b1ackmai1er/ECB-4PIO-I2C/ECB-4PIO-I2CC/ECB-4PIO.kicad_pcb

## KiCad design ECB-4PIO-I2CC/ECB-4PIO.kicad_pcb (2021-04-21)

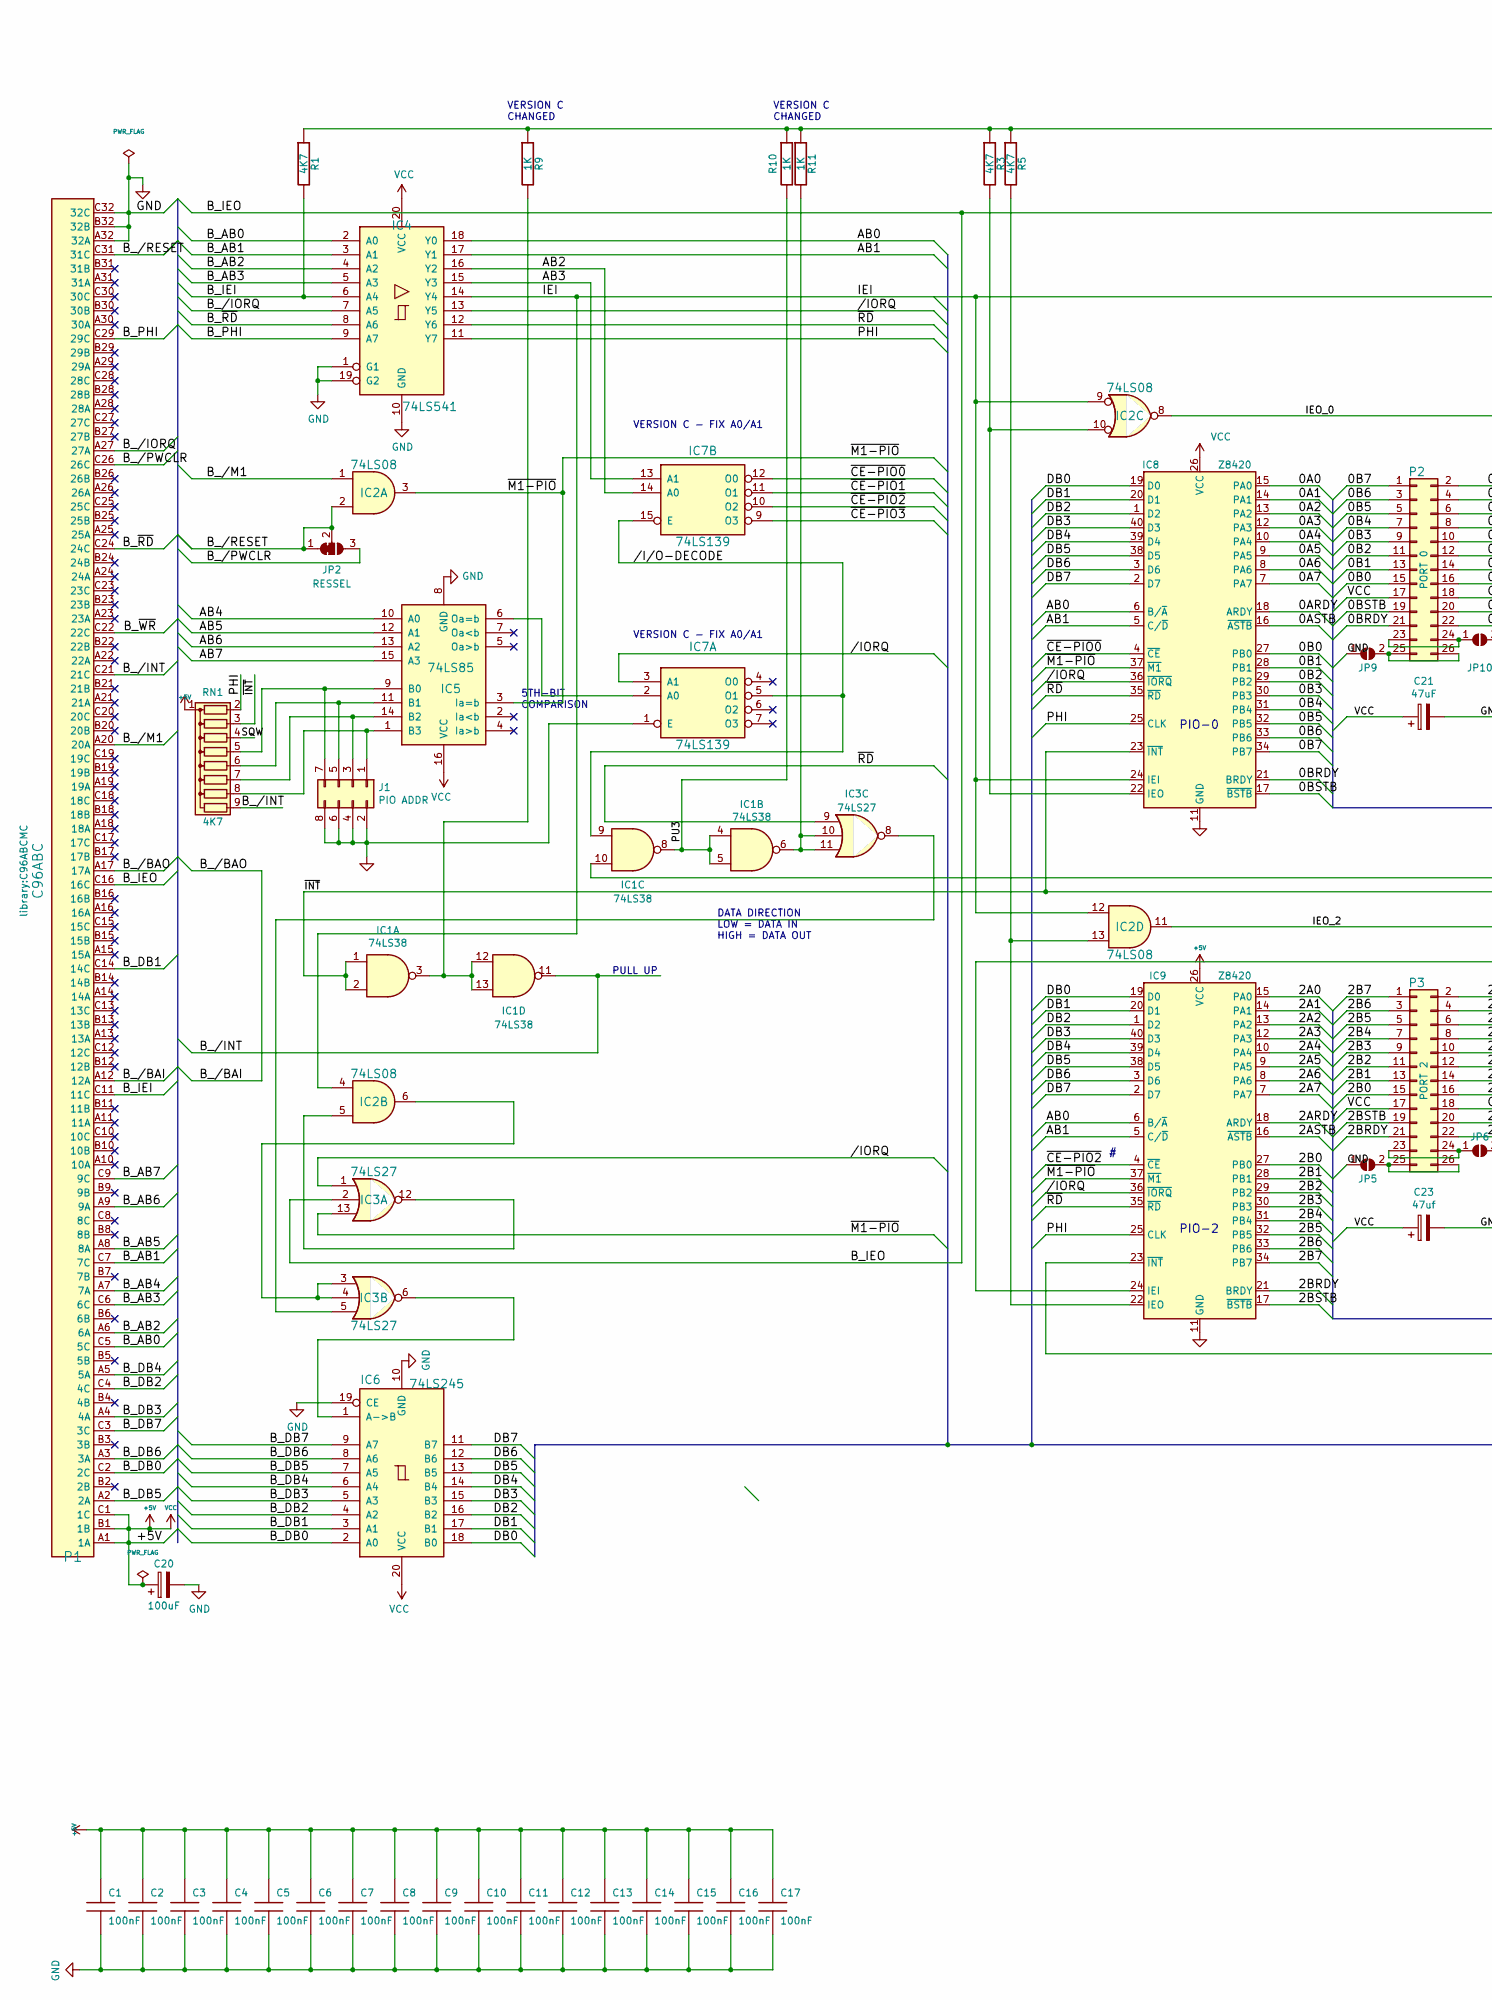
[picture p1: schematic ECB-4PIO.sch, ECB-4PIO-I2C, part in row 1, column 1]

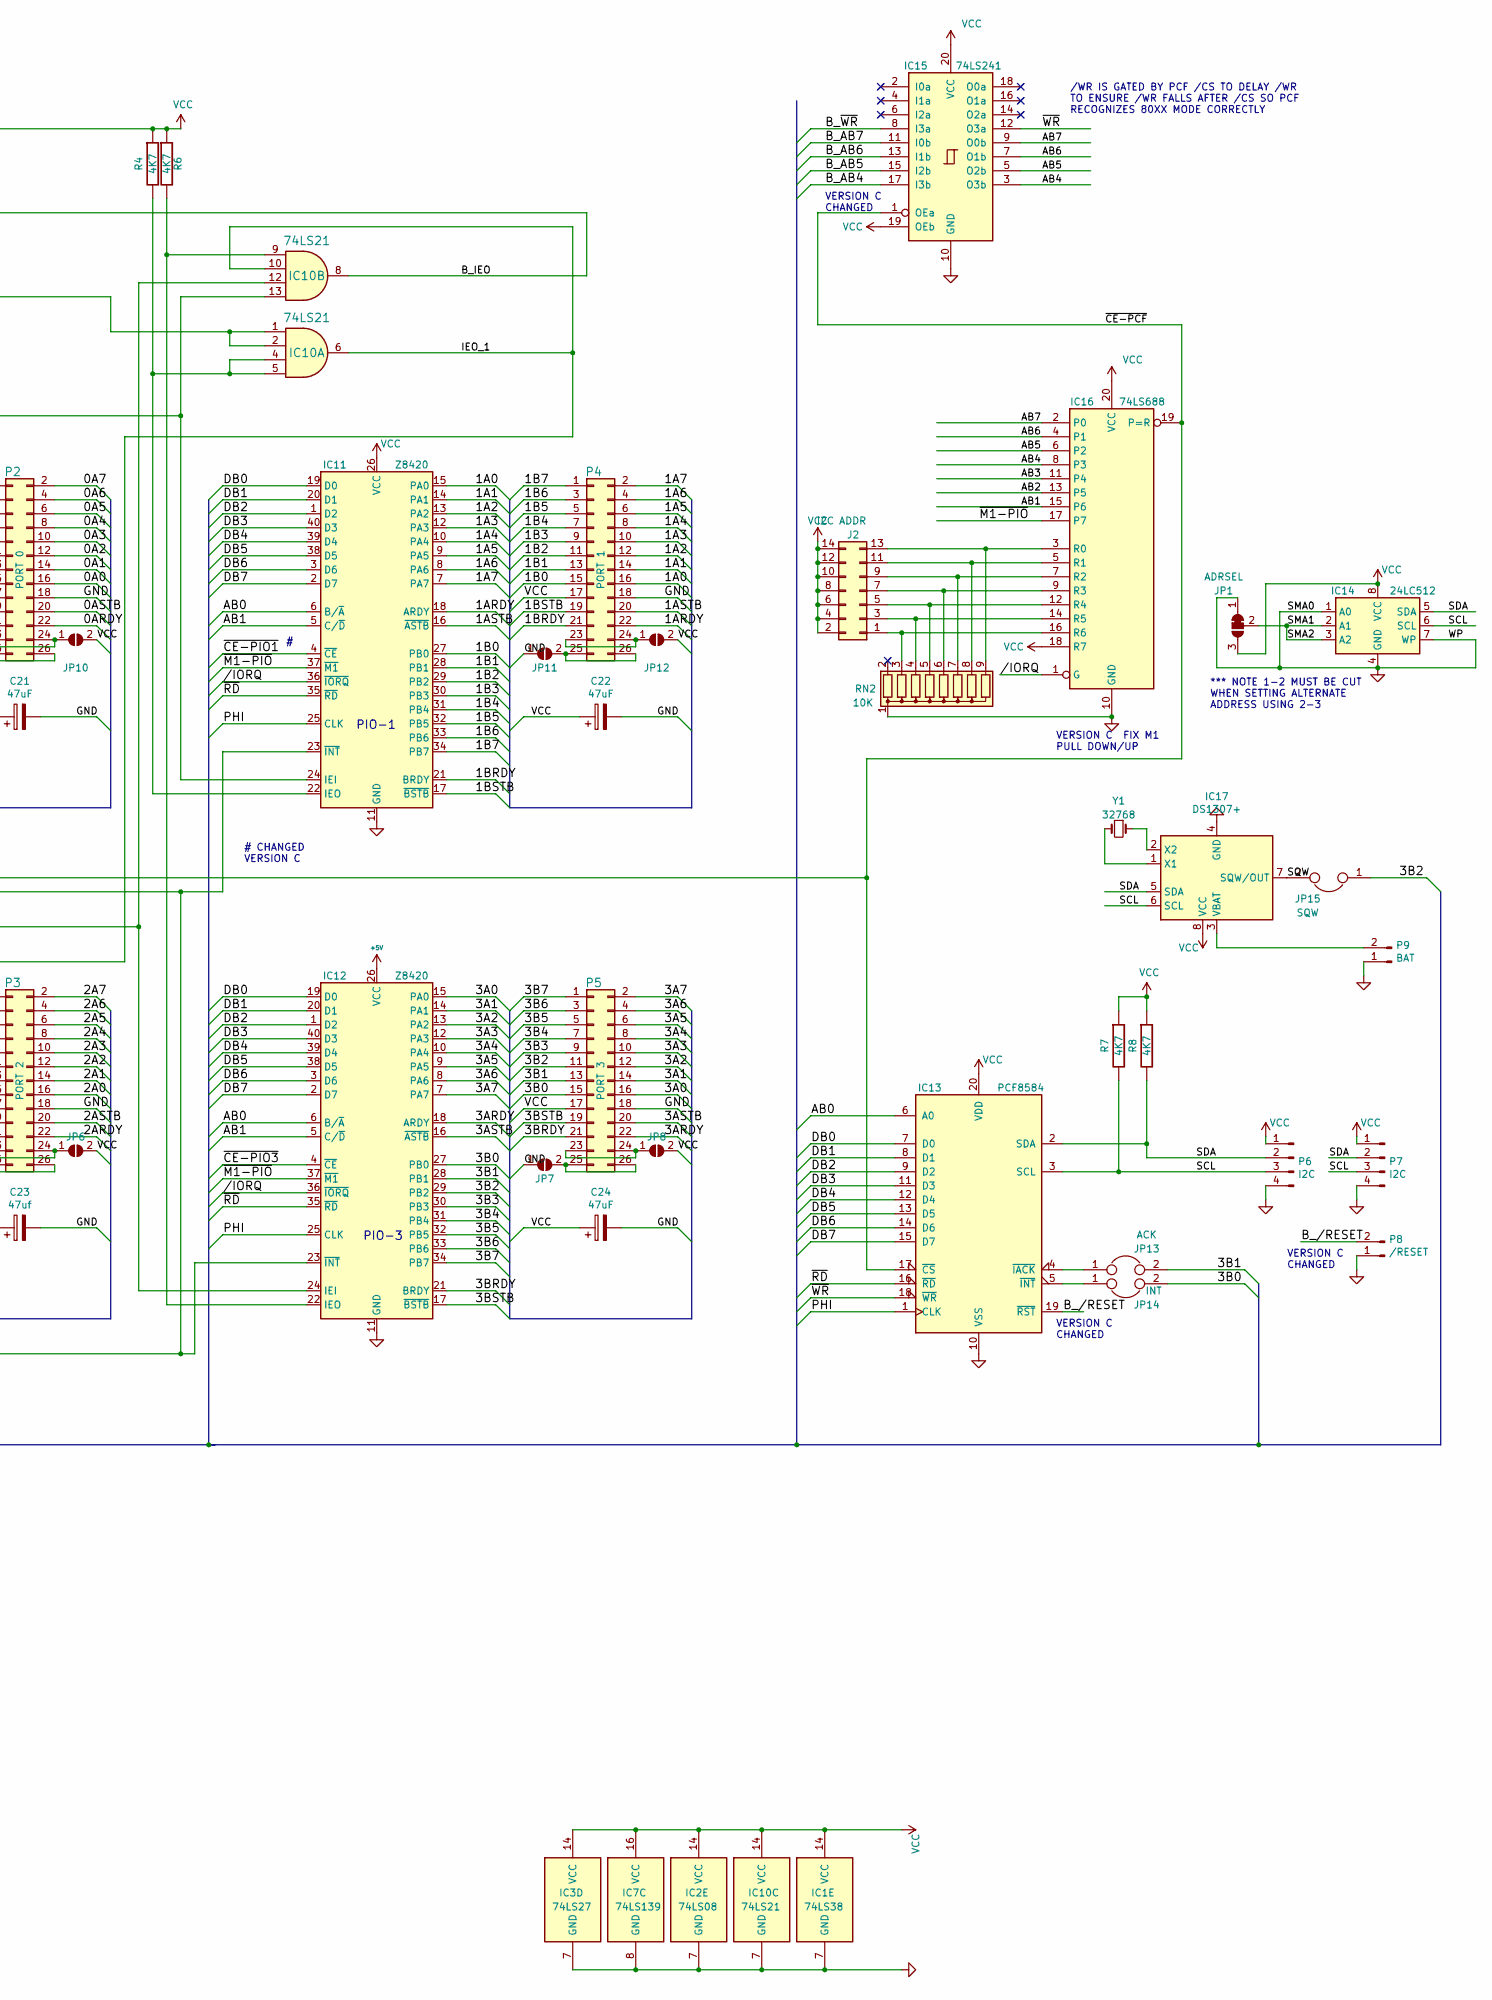
[picture p2: schematic ECB-4PIO.sch, ECB-4PIO-I2C, part in row 1, column 2]

Parts:
C1, C2, C3, C4, C5, C6, C7, C8, C9, C10, C11, C12, C13, C14, C15, C16, C17: 100nF; C_Disc_D7.0mm_W2.5mm_P5.00mm
C20: 100uF; CP_Radial_D5.0mm_P2.50mm
C21, C22, C24: 47uF; CP_Radial_D5.0mm_P2.50mm
C23: 47uf; CP_Radial_D5.0mm_P2.50mm
IC1: 74LS38; DIP-14_W7.62mm
IC2: 74LS08; DIP-14_W7.62mm
IC3: 74LS27; DIP-14_W7.62mm
IC4: 74LS541; DIP-20_W7.62mm
IC5: 74LS85; DIP-16_W7.62mm
IC6: 74LS245; DIP-20_W7.62mm
IC7: 74LS139; DIP-16_W7.62mm
IC8, IC9, IC11, IC12: Z8420; DIP-40_W15.24mm
IC10: 74LS21; DIP-14_W7.62mm
IC13: PCF8584; DIP-20_W7.62mm
IC14: 24LC512; DIP-8_W7.62mm
IC15: 74LS241; DIP-20_W7.62mm
IC16: 74LS688; DIP-20_W7.62mm
IC17: DS1307+; DIP-8_W7.62mm
J1: PIO ADDR; PinHeader_2x04_P2.54mm_Vertical
J2: I2C ADDR; PinHeader_2x07_P2.54mm_Vertical
JP1: ADRSEL; SolderJumper-3_P1.3mm_Bridged12_RoundedPad1.0x1.5mm_NumberL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
JP2: RESSEL; SolderJumper-3_P1.3mm_Bridged12_RoundedPad1.0x1.5mm_NumberL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
JP5, JP7, JP9, JP11: GND; SolderJumper-2_P1.3mm_Open_RoundedPad1.0x1.5mm
JP6, JP8, JP10, JP12: VCC; SolderJumper-2_P1.3mm_Open_RoundedPad1.0x1.5mm
JP13: ACK; PinHeader_1x02_P2.54mm_Vertical
JP14: INT; PinHeader_1x02_P2.54mm_Vertical
JP15: SQW; PinHeader_1x02_P2.54mm_Vertical
P1: C96ABC; C96ABCMC
P2: PORT 0; PinHeader_2x13_P2.54mm_Vertical
P3: PORT 2; PinHeader_2x13_P2.54mm_Vertical
P4: PORT 1; PinHeader_2x13_P2.54mm_Vertical
P5: PORT 3; PinHeader_2x13_P2.54mm_Vertical
P6, P7: I2C; PinHeader_1x04_P2.54mm_Vertical
P8: /RESET; PinHeader_1x02_P2.54mm_Vertical
P9: BAT; PinHeader_1x02_P2.54mm_Vertical
R1, R3, R4, R5, R6, R7, R8: 4K7; R_Axial_DIN0204_L3.6mm_D1.6mm_P7.62mm_Horizontal
R9, R10, R11: 1K; R_Axial_DIN0204_L3.6mm_D1.6mm_P7.62mm_Horizontal
RN1: 4K7; R_Array_SIP9
RN2: 10K; R_Array_SIP9
Y1: 32768; Crystal_Round_D3.0mm_Vertical

Connections:
/0A0: IC8.15 (PA0), P2.16
/0A1: IC8.14 (PA1), P2.14
/0A2: IC8.13 (PA2), P2.12
/0A3: IC8.12 (PA3), P2.10
/0A4: IC8.10 (PA4), P2.8
/0A5: IC8.9 (PA5), P2.6
/0A6: IC8.8 (PA6), P2.4
/0A7: IC8.7 (PA7), P2.2
/0ARDY: IC8.18 (ARDY), P2.22
/0ASTB: IC8.16 (~ASTB~), P2.20
/0B0: IC8.27 (PB0), P2.15
/0B1: IC8.28 (PB1), P2.13
/0B2: IC8.29 (PB2), P2.11
/0B3: IC8.30 (PB3), P2.9
/0B4: IC8.31 (PB4), P2.7
/0B5: IC8.32 (PB5), P2.5
/0B6: IC8.33 (PB6), P2.3
/0B7: IC8.34 (PB7), P2.1
/0BRDY: IC8.21 (BRDY), P2.21
/0BSTB: IC8.17 (~BSTB~), P2.19
/1A0: IC11.15 (PA0), P4.16
/1A1: IC11.14 (PA1), P4.14
/1A2: IC11.13 (PA2), P4.12
/1A3: IC11.12 (PA3), P4.10
/1A4: IC11.10 (PA4), P4.8
/1A5: IC11.9 (PA5), P4.6
/1A6: IC11.8 (PA6), P4.4
/1A7: IC11.7 (PA7), P4.2
/1ARDY: IC11.18 (ARDY), P4.22
/1ASTB: IC11.16 (~ASTB~), P4.20
/1B0: IC11.27 (PB0), P4.15
/1B1: IC11.28 (PB1), P4.13
/1B2: IC11.29 (PB2), P4.11
/1B3: IC11.30 (PB3), P4.9
/1B4: IC11.31 (PB4), P4.7
/1B5: IC11.32 (PB5), P4.5
/1B6: IC11.33 (PB6), P4.3
/1B7: IC11.34 (PB7), P4.1
/1BRDY: IC11.21 (BRDY), P4.21
/1BSTB: IC11.17 (~BSTB~), P4.19
/2A0: IC9.15 (PA0), P3.16
/2A1: IC9.14 (PA1), P3.14
/2A2: IC9.13 (PA2), P3.12
/2A3: IC9.12 (PA3), P3.10
/2A4: IC9.10 (PA4), P3.8
/2A5: IC9.9 (PA5), P3.6
/2A6: IC9.8 (PA6), P3.4
/2A7: IC9.7 (PA7), P3.2
/2ARDY: IC9.18 (ARDY), P3.22
/2ASTB: IC9.16 (~ASTB~), P3.20
/2B0: IC9.27 (PB0), P3.15
/2B1: IC9.28 (PB1), P3.13
/2B2: IC9.29 (PB2), P3.11
/2B3: IC9.30 (PB3), P3.9
/2B4: IC9.31 (PB4), P3.7
/2B5: IC9.32 (PB5), P3.5
/2B6: IC9.33 (PB6), P3.3
/2B7: IC9.34 (PB7), P3.1
/2BRDY: IC9.21 (BRDY), P3.21
/2BSTB: IC9.17 (~BSTB~), P3.19
/3A0: IC12.15 (PA0), P5.16
/3A1: IC12.14 (PA1), P5.14
/3A2: IC12.13 (PA2), P5.12
/3A3: IC12.12 (PA3), P5.10
/3A4: IC12.10 (PA4), P5.8
/3A5: IC12.9 (PA5), P5.6
/3A6: IC12.8 (PA6), P5.4
/3A7: IC12.7 (PA7), P5.2
/3ARDY: IC12.18 (ARDY), P5.22
/3ASTB: IC12.16 (~ASTB~), P5.20
/3B0: IC12.27 (PB0), JP14.2, P5.15
/3B1: IC12.28 (PB1), JP13.2, P5.13
/3B2: IC12.29 (PB2), JP15.1, P5.11
/3B3: IC12.30 (PB3), P5.9
/3B4: IC12.31 (PB4), P5.7
/3B5: IC12.32 (PB5), P5.5
/3B6: IC12.33 (PB6), P5.3
/3B7: IC12.34 (PB7), P5.1
/3BRDY: IC12.21 (BRDY), P5.21
/3BSTB: IC12.17 (~BSTB~), P5.19
//I/O-DECODE: IC1.9, IC7.5 (O1), IC7.15 (E)
//IORQ: IC3.1, IC4.13 (Y5), IC7.3 (A1), IC8.36 (~IORQ~), IC9.36 (~IORQ~), IC11.36 (~IORQ~), IC12.36 (~IORQ~), IC16.1 (G)
/AB0: IC4.18 (Y0), IC8.6 (B/~A~), IC9.6 (B/~A~), IC11.6 (B/~A~), IC12.6 (B/~A~), IC13.6 (A0)
/AB1: IC4.17 (Y1), IC8.5 (C/~D~), IC9.5 (C/~D~), IC11.5 (C/~D~), IC12.5 (C/~D~), IC16.15 (P6)
/AB2: IC4.16 (Y2), IC7.14 (A0), IC16.13 (P5)
/AB3: IC4.15 (Y3), IC7.13 (A1), IC16.11 (P4)
/AB4: IC5.10 (A0), IC15.3 (O3b), IC16.8 (P3)
/AB5: IC5.12 (A1), IC15.5 (O2b), IC16.6 (P2)
/AB6: IC5.13 (A2), IC15.7 (O1b), IC16.4 (P1)
/AB7: IC5.15 (A3), IC15.9 (O0b), IC16.2 (P0)
/B_/BAI: P1.A12 (12A), P1.A17 (17A)
/B_/INT: IC1.11, P1.C21 (21C), RN1.9 (R8)
/B_/IORQ: IC4.7 (A5), P1.A27 (27A)
/B_/M1: IC2.1, P1.A20 (20A)
/B_/PWCLR: JP2.3 (B), P1.C26 (26C)
/B_/RESET: IC2.2, IC13.19 (~RST~), JP2.1 (A), JP2.2 (C), P1.C31 (31C), P8.2
/B_AB0: IC4.2 (A0), P1.C5 (5C)
/B_AB1: IC4.3 (A1), P1.C7 (7C)
/B_AB2: IC4.4 (A2), P1.A6 (6A)
/B_AB3: IC4.5 (A3), P1.C6 (6C)
/B_AB4: IC15.17 (I3b), P1.A7 (7A)
/B_AB5: IC15.15 (I2b), P1.A8 (8A)
/B_AB6: IC15.13 (I1b), P1.A9 (9A)
/B_AB7: IC15.11 (I0b), P1.C9 (9C)
/B_DB0: IC6.2 (A0), P1.C2 (2C)
/B_DB1: IC6.3 (A1), P1.C14 (14C)
/B_DB2: IC6.4 (A2), P1.C4 (4C)
/B_DB3: IC6.5 (A3), P1.A4 (4A)
/B_DB4: IC6.6 (A4), P1.A5 (5A)
/B_DB5: IC6.7 (A5), P1.A2 (2A)
/B_DB6: IC6.8 (A6), P1.A3 (3A)
/B_DB7: IC6.9 (A7), P1.C3 (3C)
/B_IEI: IC4.6 (A4), P1.C11 (11C), R1.2
/B_IEO: IC3.2, IC10.8, P1.C16 (16C)
/B_PHI: IC4.9 (A7), P1.C29 (29C)
/B_~RD: IC4.8 (A6), P1.C24 (24C)
/B_~WR: IC15.8 (I3a), P1.C22 (22C)
/DB0: IC6.18 (B0), IC8.19 (D0), IC9.19 (D0), IC11.19 (D0), IC12.19 (D0), IC13.7 (D0)
/DB1: IC6.17 (B1), IC8.20 (D1), IC9.20 (D1), IC11.20 (D1), IC12.20 (D1), IC13.8 (D1)
/DB2: IC6.16 (B2), IC8.1 (D2), IC9.1 (D2), IC11.1 (D2), IC12.1 (D2), IC13.9 (D2)
/DB3: IC6.15 (B3), IC8.40 (D3), IC9.40 (D3), IC11.40 (D3), IC12.40 (D3), IC13.11 (D3)
/DB4: IC6.14 (B4), IC8.39 (D4), IC9.39 (D4), IC11.39 (D4), IC12.39 (D4), IC13.12 (D4)
/DB5: IC6.13 (B5), IC8.38 (D5), IC9.38 (D5), IC11.38 (D5), IC12.38 (D5), IC13.13 (D5)
/DB6: IC6.12 (B6), IC8.3 (D6), IC9.3 (D6), IC11.3 (D6), IC12.3 (D6), IC13.14 (D6)
/DB7: IC6.11 (B7), IC8.2 (D7), IC9.2 (D7), IC11.2 (D7), IC12.2 (D7), IC13.15 (D7)
/IEI: IC2.4, IC2.9, IC2.12, IC4.14 (Y4), IC8.24 (IEI), IC10.1, IC10.2
/IEO_0: IC2.8, IC10.13, IC11.24 (IEI)
/IEO_1: IC9.24 (IEI), IC10.6, IC10.10
/IEO_2: IC2.11, IC10.12, IC12.24 (IEI)
/PHI: IC4.11 (Y7), IC8.25 (CLK), IC9.25 (CLK), IC11.25 (CLK), IC12.25 (CLK), IC13.1 (CLK), RN1.2 (R1)
/PU3: IC1.4, IC1.5, IC1.8, R10.2
/SCL: IC13.3 (SCL), IC14.6 (SCL), IC17.6 (SCL), P6.3, P7.3, R7.2
/SDA: IC13.2 (SDA), IC14.5 (SDA), IC17.5 (SDA), P6.2, P7.2, R8.2
/SMA1: IC14.2 (A1), IC14.3 (A2), JP1.2 (C)
/SQW: IC17.7 (SQW/OUT), JP15.2, RN1.4 (R3)
/~CE-PCF: IC1.10, IC13.17 (~CS~), IC15.1 (OEa), IC16.19 (P=R)
/~CE-PIO0: IC7.12 (O0), IC8.4 (~CE~)
/~CE-PIO1: IC7.11 (O1), IC11.4 (~CE~)
/~CE-PIO2: IC7.10 (O2), IC9.4 (~CE~)
/~CE-PIO3: IC7.9 (O3), IC12.4 (~CE~)
/~INT: IC1.1, IC1.2, IC8.23 (~INT~), IC9.23 (~INT~), IC11.23 (~INT~), IC12.23 (~INT~), RN1.3 (R2)
/~M1-PIO: IC2.3, IC3.13, IC5.3 (Ia=b), IC8.37 (~M1~), IC9.37 (~M1~), IC11.37 (~M1~), IC12.37 (~M1~), IC16.17 (P7)
/~RD: IC3.9, IC4.12 (Y6), IC8.35 (~RD~), IC9.35 (~RD~), IC11.35 (~RD~), IC12.35 (~RD~), IC13.16 (~RD~)
/~WR: IC13.18 (~WR~), IC15.12 (O3a)
GND: C1.2, C2.2, C3.2, C4.2, C5.2, C6.2, C7.2, C8.2, C9.2, C10.2, C11.2, C12.2, C13.2, C14.2, C15.2, C16.2, C17.2, C20.2, C21.2, C22.2, C23.2, C24.2, IC1.7 (GND), IC2.7 (GND), IC3.7 (GND), IC4.1 (G1), IC4.10 (GND), IC4.19 (G2), IC5.8 (GND), IC6.10 (GND), IC6.19 (CE), IC7.1 (E), IC7.8 (GND), IC8.11 (GND), IC9.11 (GND), IC10.7 (GND), IC11.11 (GND), IC12.11 (GND), IC13.10 (VSS), IC14.1 (A0), IC14.4 (GND), IC14.7 (WP), IC15.10 (GND), IC16.10 (GND), IC17.4 (GND), J1.2, J1.4, J1.6, J1.8, JP1.1 (A), JP5.1 (A), JP7.1 (A), JP9.1 (A), JP11.1 (A), P1.A32 (32A), P1.B32 (32B), P1.C32 (32C), P2.18, P3.18, P4.18, P5.18, P6.4, P7.4, P8.1, P9.1, RN2.1 (common)
unnamed: IC1.6, IC3.10, IC3.11, R11.2
unnamed: IC1.3, IC1.12, IC1.13, R9.2
unnamed: IC2.5, IC3.12
unnamed: IC2.6, IC3.3, IC3.4
unnamed: IC2.10, IC8.22 (IEO), R3.2
unnamed: IC2.13, IC9.22 (IEO), R5.2
unnamed: IC3.5, IC3.8
unnamed: IC3.6, IC6.1 (A->B)
unnamed: IC5.1 (B3), J1.1, RN1.8 (R7)
unnamed: IC5.6 (Oa=b), IC7.2 (A0)
unnamed: IC5.9 (B0), J1.7, RN1.5 (R4)
unnamed: IC5.11 (B1), J1.5, RN1.6 (R5)
unnamed: IC5.14 (B2), J1.3, RN1.7 (R6)
unnamed: IC10.4, IC10.5, IC11.22 (IEO), R4.2
unnamed: IC10.9, IC12.22 (IEO), R6.2
unnamed: IC13.4 (~IACK~), JP13.1
unnamed: IC13.5 (~INT~), JP14.1
unnamed: IC16.3 (R0), J2.13, RN2.9 (R8)
unnamed: IC16.5 (R1), J2.11, RN2.8 (R7)
unnamed: IC16.7 (R2), J2.9, RN2.7 (R6)
unnamed: IC16.9 (R3), J2.7, RN2.6 (R5)
unnamed: IC16.12 (R4), J2.5, RN2.5 (R4)
unnamed: IC16.14 (R5), J2.3, RN2.4 (R3)
unnamed: IC16.16 (R6), J2.1, RN2.3 (R2)
unnamed: IC17.1 (X1), Y1.2
unnamed: IC17.2 (X2), Y1.1
unnamed: IC17.3 (VBAT), P9.2
unnamed: JP5.2 (B), P3.25, P3.26
unnamed: JP6.1 (A), P3.23, P3.24
unnamed: JP7.2 (B), P5.25, P5.26
unnamed: JP8.1 (A), P5.23, P5.24
unnamed: JP9.2 (B), P2.25, P2.26
unnamed: JP10.1 (A), P2.23, P2.24
unnamed: JP11.2 (B), P4.25, P4.26
unnamed: JP12.1 (A), P4.23, P4.24
VCC: C1.1, C2.1, C3.1, C4.1, C5.1, C6.1, C7.1, C8.1, C9.1, C10.1, C11.1, C12.1, C13.1, C14.1, C15.1, C16.1, C17.1, C20.1, C21.1, C22.1, C23.1, C24.1, IC1.14 (VCC), IC2.14 (VCC), IC3.14 (VCC), IC4.20 (VCC), IC5.16 (VCC), IC6.20 (VCC), IC7.16 (VCC), IC8.26 (VCC), IC9.26 (VCC), IC10.14 (VCC), IC11.26 (VCC), IC12.26 (VCC), IC13.20 (VDD), IC14.8 (VCC), IC15.19 (OEb), IC15.20 (VCC), IC16.18 (R7), IC16.20 (VCC), IC17.8 (VCC), J2.2, J2.4, J2.6, J2.8, J2.10, J2.12, J2.14, JP1.3 (B), JP6.2 (B), JP8.2 (B), JP10.2 (B), JP12.2 (B), P1.A1 (1A), P1.B1 (1B), P1.C1 (1C), P2.17, P3.17, P4.17, P5.17, P6.1, P7.1, R1.1, R3.1, R4.1, R5.1, R6.1, R7.1, R8.1, R9.1, R10.1, R11.1, RN1.1 (common)

Notes on the sheet:
PIO-3
PIO-2
PIO-1
PIO-0
PULL UP
VERSION C - FIX A0/A1
5TH-BIT COMPARISON
VERSION C FIX M1 PULL DOWN/UP
DATA DIRECTION LOW = DATA IN HIGH = DATA OUT
VERSION C CHANGED
# CHANGED VERSION C
*** NOTE 1-2 MUST BE CUT WHEN SETTING ALTERNATE ADDRESS USING 2-3
/WR IS GATED BY PCF /CS TO DELAY /WR TO ENSURE /WR FALLS AFTER /CS SO PCF RECOGNIZES 80XX MODE CORRECTLY

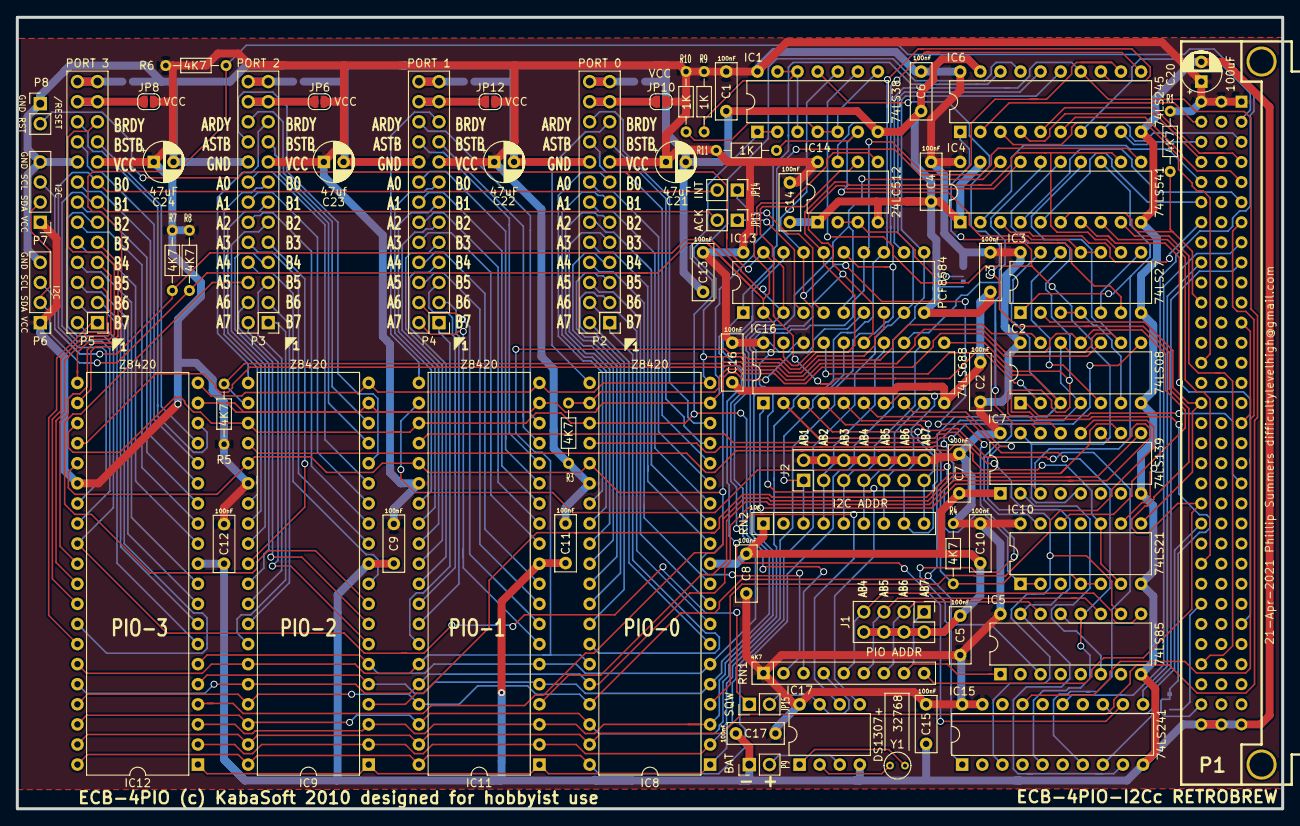
[picture p3: board ECB-4PIO.kicad_pcb from above]

Board: 2 copper layers, 160.0 x 100.1 mm, 76 parts (0 on the bottom side), 181 nets.
