b1ackmai1er/ECB-4PIO-I2C/(commit log)

2021-02-28 Version A - Initial release
    [ECB-4PIO.sch]
2021-02-28 Version B - Add DS1307 RTC
    [ECB-4PIO.sch]
2021-04-21 Version C- First working prototype
    [ECB-4PIO.kicad_pcb, ECB-4PIO.sch]
